chiradip/sonus-minimal/docs/original/diagrams/01_system_block.png

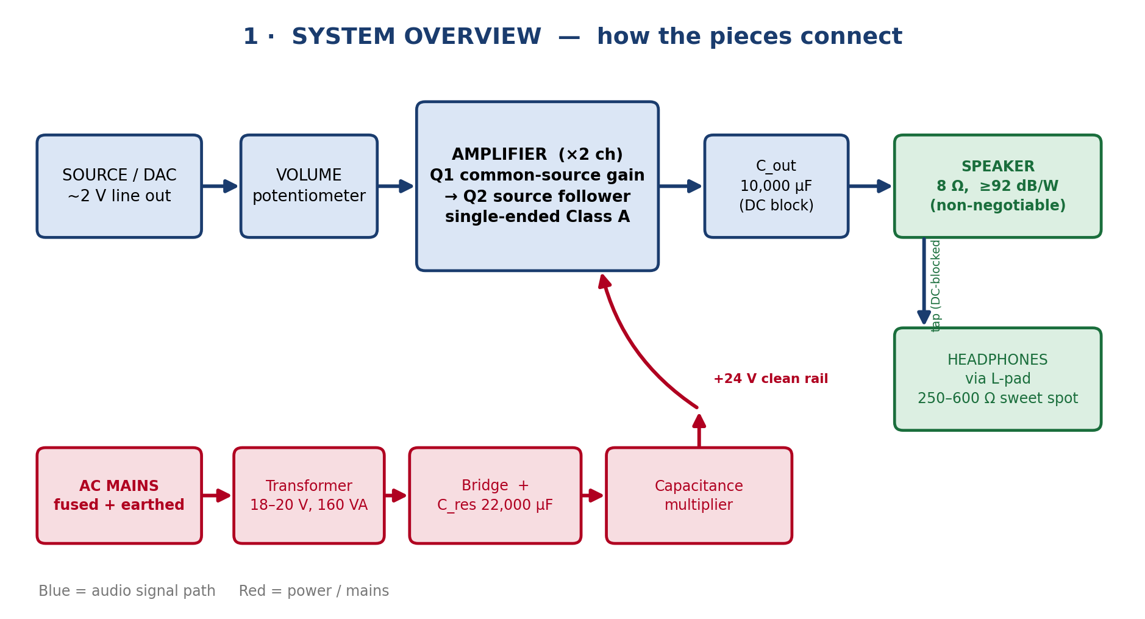
docs/original/diagrams/01_system_block.png
