chiradip/sonus-minimal/docs/original/diagrams/02_channel_schematic.png

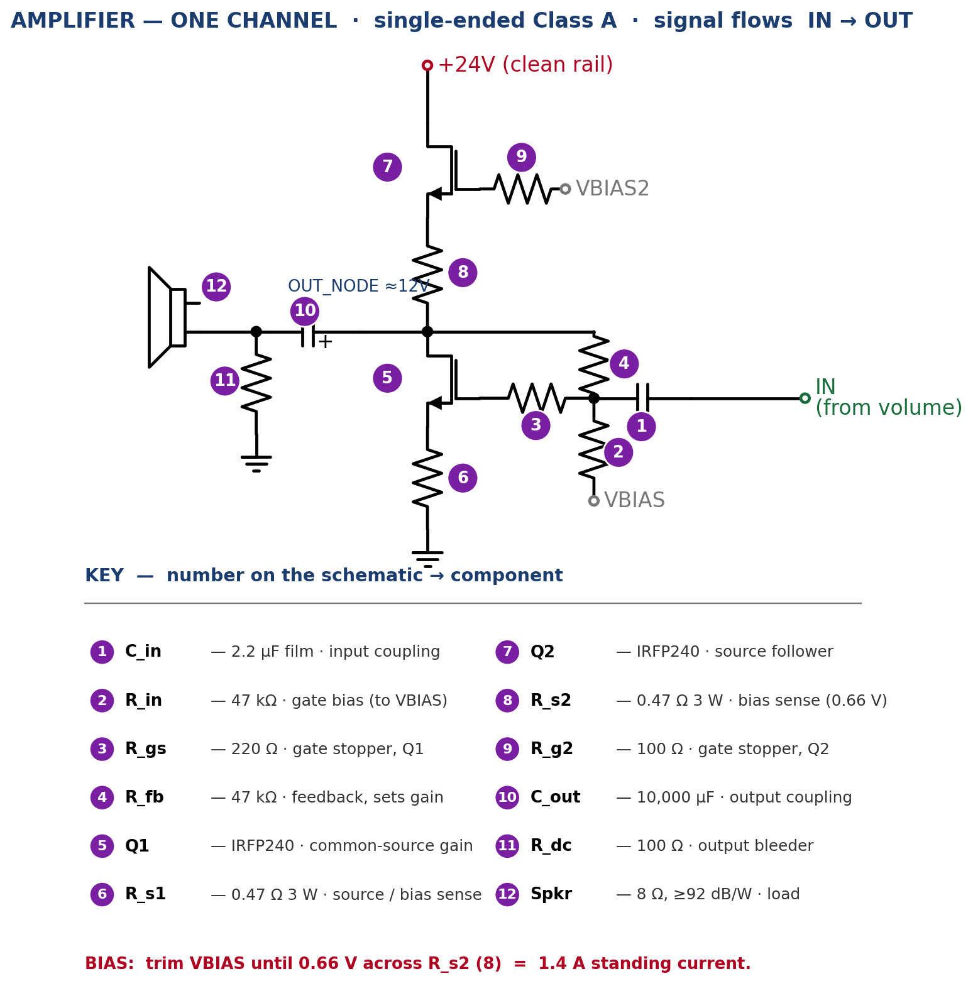
docs/original/diagrams/02_channel_schematic.png
