chiradip/sonus-minimal/docs/original/diagrams/03_power_supply.png

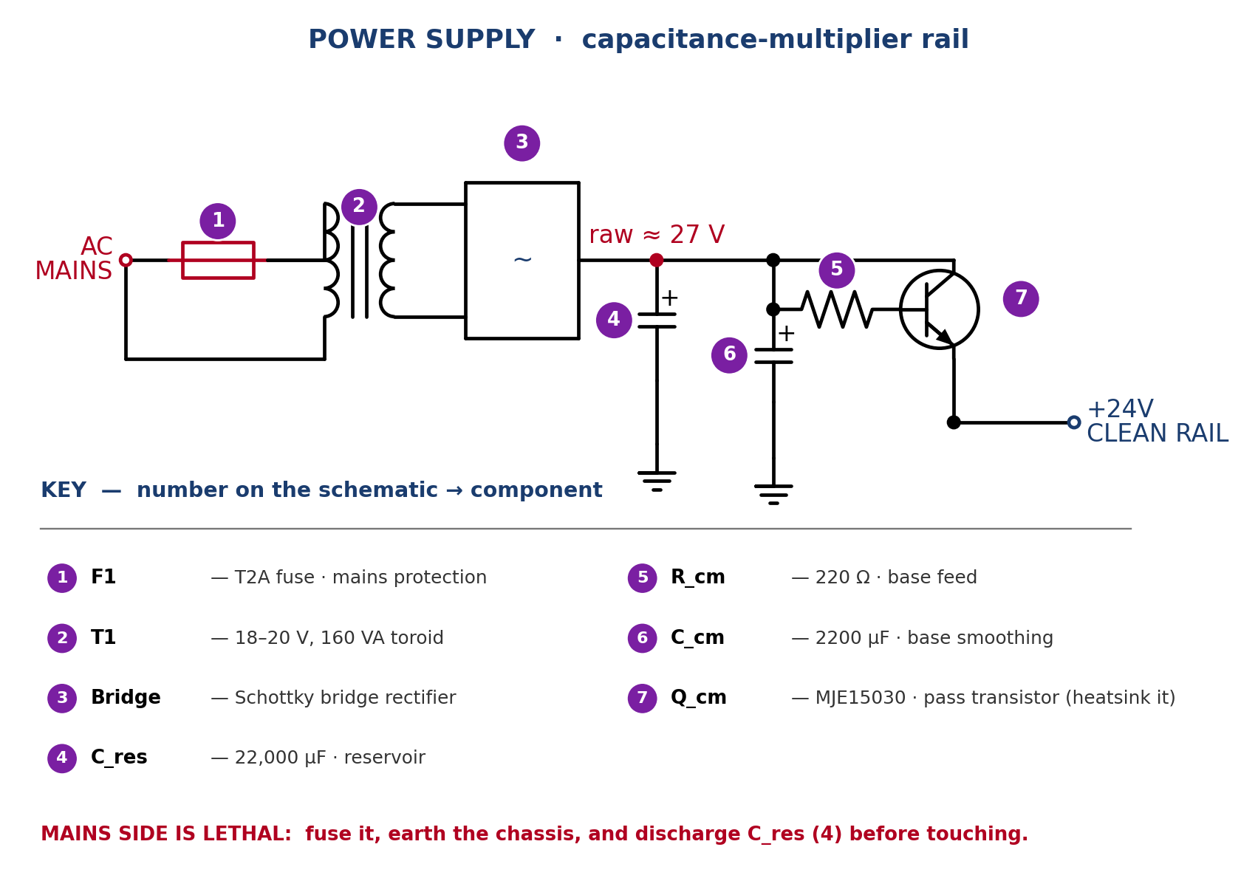
docs/original/diagrams/03_power_supply.png
