chiradip/sonus-minimal/docs/original/diagrams/04_physical_layout.png

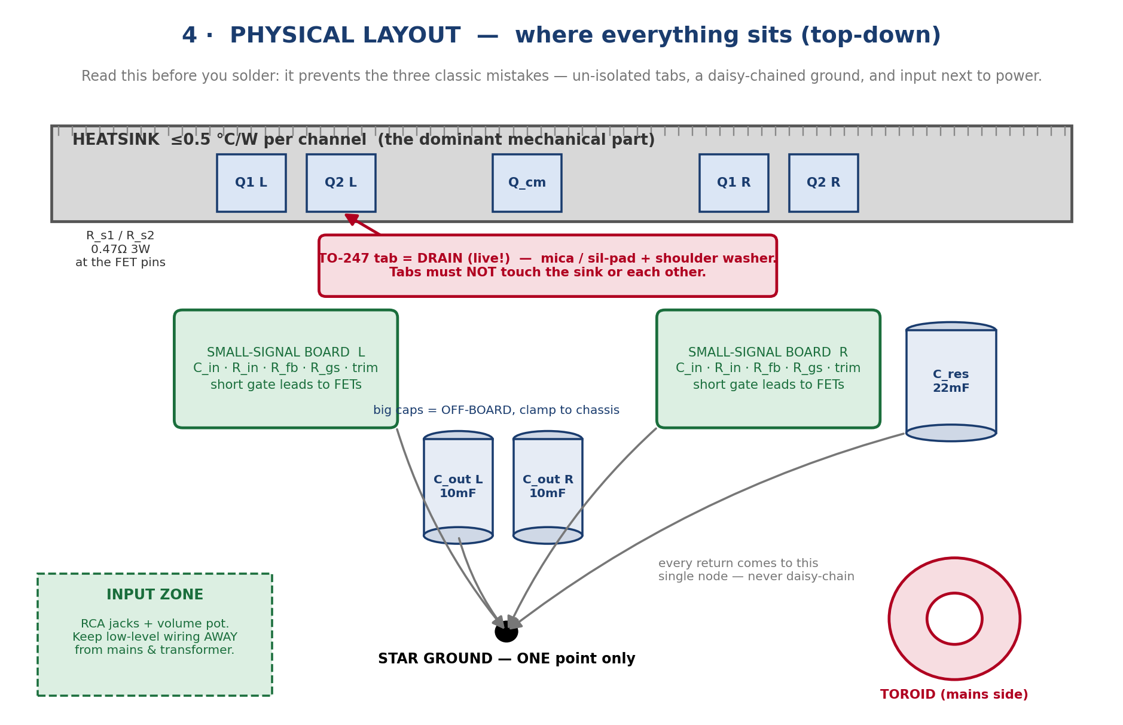
docs/original/diagrams/04_physical_layout.png
