chiradip/sonus-minimal/docs/BOM-rev4-delta-3-gaps.csv

Quantity | Manufacturer Part Number | Customer Reference | Description | Qty per amp (stereo) | Alternate MPN | Notes
12 | SP400-0.007-00-104 | INS (Q1/Q2) | Sil-Pad 400 insulator 25.4x19.05mm, TO-218/220/247 (Bergquist/Henkel) | 4 | Fischer WK 247; Wakefield WTI7R1F0-1.00X0.75 | VERIFIED 2026-07-04 on DigiKey: in stock (7002), $0.25, listed TO-247 compatible. Covers GAP-1 (4880SG/4880MG are TO-220 - confirmed on product page). 8 used (2 amps) + 4 spares. Sil-pad: no grease on these joints.
12 | TO247-BUSHING | INS-BUSH (Q1/Q2) | Insulating shoulder washer/bushing for TO-247 mounting screw, nylon | 4 | Essentra/Boyd TO-247 bushing | Belt-and-suspenders: most TO-247 incl. IRFP150N have a PLASTIC-lined mounting hole (screw never touches the tab) - inspect your devices: metal visible in the hole = bushing required; plastic = optional. Placeholder P/N - select in-stock at cart if needed.
