chiradip/sonus-minimal/docs/original/diagrams/05_build_sequence.png

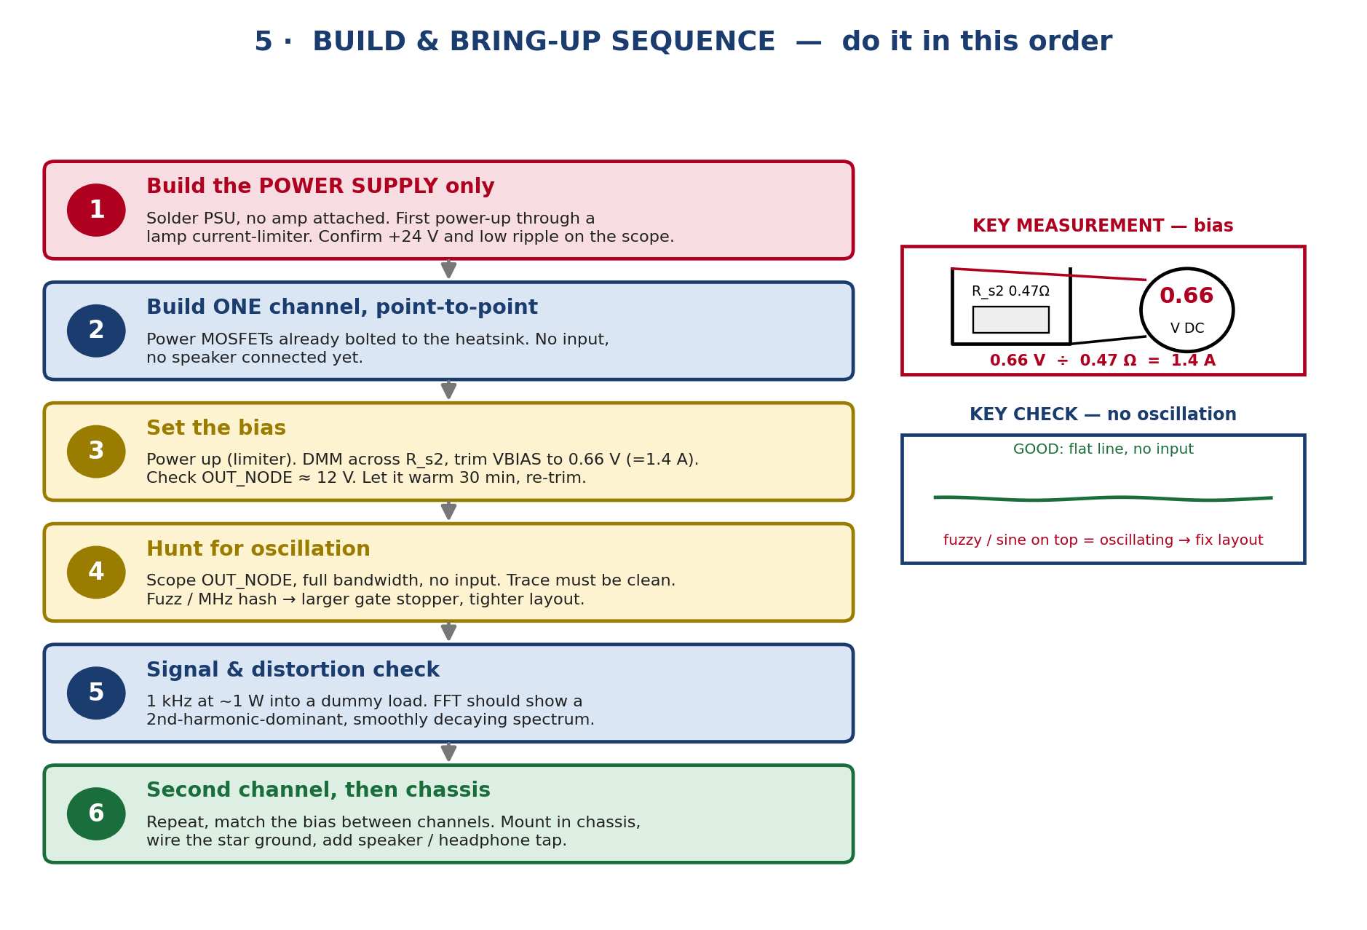
docs/original/diagrams/05_build_sequence.png
