chiradip/sonus-minimal/(commit log)

2026-07-04 Sonus Minimal build package: lab book rev A, design rev 4
    Complete, resolved build package for the SE Class A 5 W amplifier
    (3 stereo units), derived from the rev 3 handoff with all eight open
    items closed as ECR-1..8:
    - LABBOOK.md: sequential build lab book (theory primer, ECR log with
    shown math, DC voltage maps, phases A-G with gates and record tables,
    troubleshooting, appendices) + PDF book edition (35 pp, vector figs)
    - docs/BOM-rev4.csv: authoritative parts list; Darlington multiplier
    parts, Zobel, bias-select kit, inrush NTC added; R_fb/Rb_bot re-centred
    for the IRFP150N (both fixes verified numerically)
    - diagrams/fig01-fig10: rev A SVG figures - schematics with annotated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
    [BOM-rev4.csv, SE-ClassA-5W-BOM-3amps-digikey-rev3.csv]
2026-07-04 Add rev3->rev4 delta order files + rationale doc
    - BOM-rev4-delta-1-additions.csv: parts rev3 lacked entirely (Darlington
    multiplier set, Zobel, bias-select kit, TO-220 insulator, FET sorting
    top-up, bench tools)
    - BOM-rev4-delta-2-replacements.csv: parts superseding rev3 stock
    (R_fb 82k, Rb_bot 22k, 50V UPW electrolytics)
    - BOM-rev3-to-rev4-DELTA.md: per-part explanation of why the superseded
    rev3 parts must not be stuffed, plus quarantine checklist
    - README: pointer for builders holding a rev3 order
    [BOM-rev4-delta-1-additions.csv, BOM-rev4-delta-2-replacements.csv]
2026-07-05 part_tracking: T1 toroids and HS1 heatsinks ordered 2026-07-04
2026-07-05 Audit of base-order invoice 128236717: log + 3 gaps found
    - part_tracking: base order (rev-3, 26-Jun, $876.94) logged with
    substitutions noted (Vishay IRFP150PBF != IRFP150N; PNP300 R_s;
    TDK C_in); two-FET-type policy note added
    - GAPS: zero TO-247 insulators on hand (4880SG proved to be TO-220 by
    invoice description - build blocker for Phase D), binding posts 4/6,
    toroids 2/3 pending confirmation
    - BOM-rev4: INS line corrected - 4880SG unsuitable for TO-247, kit to
    be selected in-stock at cart
    [BOM-rev4.csv]
2026-07-05 delta-3 gap order file (TO-247 insulator kits, binding posts); third toroid confirmed ordered separately
    [BOM-rev4-delta-3-gaps.csv]
2026-07-05 Scope change: 2 units (SM-001, SM-002); 3-amp part depth = attrition buffer
    - LABBOOK: cover serial table, time budget, Phase G, Appendix A scoped
    to 2 units; SM-003 row marked attrition stock; scope note in header;
    PDF regenerated
    - delta-3: binding-post line dropped (4 posts = exactly 2 amps),
    insulators right-sized to 12
    - part_tracking: scope banner added, gap-2 resolved by scope change,
    snapshot updated
    [BOM-rev4-delta-3-gaps.csv]
2026-07-05 delta-3: SP400-0.007-00-104 verified TO-247-compatible/in-stock on DigiKey; 4880SG confirmed TO-220 via product page; bushing rule clarified
    [BOM-rev4-delta-3-gaps.csv]
2026-07-05 fix literal backslash-dollar artifacts in delta-3 and tracking notes
    [BOM-rev4-delta-3-gaps.csv]
2026-07-05 delta-4: consumables/hardware order file (perfboard, Q_cm heatsink, mains terminals, dim-bulb makings) + tracking hooks
    [BOM-rev4-delta-4-consumables.csv]
2026-07-05 pcb-milling-exercise: JIG-1 warm-up board for Makera Carvera
    Fig. 4 V_GS jig as a single-sided milled PCB - the simplest real board
    (3 nets: VIN+, drain-gate-tied island, GND sea) and independently
    testable (it IS the Phase A instrument):
    - make_gcode.py generator + 6 ready-to-run .nc files (isolation, 4
    drill sizes, tabbed cutout), pre-mirrored for copper-side-up milling,
    plain G0/G1 for the Carvera controller
    - copper plan + as-machined SVGs embedded in the exercise README
    - run sequence, feeds/speeds, buzz-out and live acceptance test
    - one physical verify flagged: R_j body length vs 54 mm pad pitch
2026-07-05 JIG-1 rev B: dual-purpose R_j footprint (axial OR aluminum-housed)
    User's Amazon R_j is an aluminum-shell chassis-mount type (solder lugs,
    1.8mm holes), not the axial TWW10J6R8E. Rev B makes the two R_j pads
    1.6mm dual-purpose: axial part solders across them, aluminum part bolts
    to the plate (its 10W rating needs the heatsink - the jig runs it at
    100% rating) and wires to the same pads. Dropped the 1.2mm drill file;
    SVGs, README and G-code regenerated.
2026-07-06 JIG-1: ATC slot map T1-T5 wired into G-code (single-line T# M6), README slot table
2026-07-06 JIG-1 README: tin the copper, no solder mask needed
2026-07-06 JIG-1: T1 bit guidance corrected to pack-real 0.2mm tips (0.1mm not in pack; groove math shown, no depth change needed)
2026-07-06 JIG-1 README: 150x100 stock guidance (origin 5mm inset, nesting note)
